JorgeSuarezPorras/ConvertidorElectronicoCC-CA/PCB_FINAL/PCB_FINAL.png

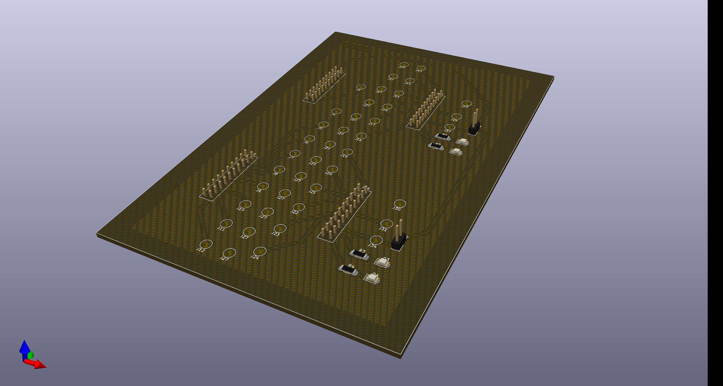
PCB_FINAL/PCB_FINAL.png
