JorgeSuarezPorras/ConvertidorElectronicoCC-CA/PCB_FINAL/PCB_BACK.pdf

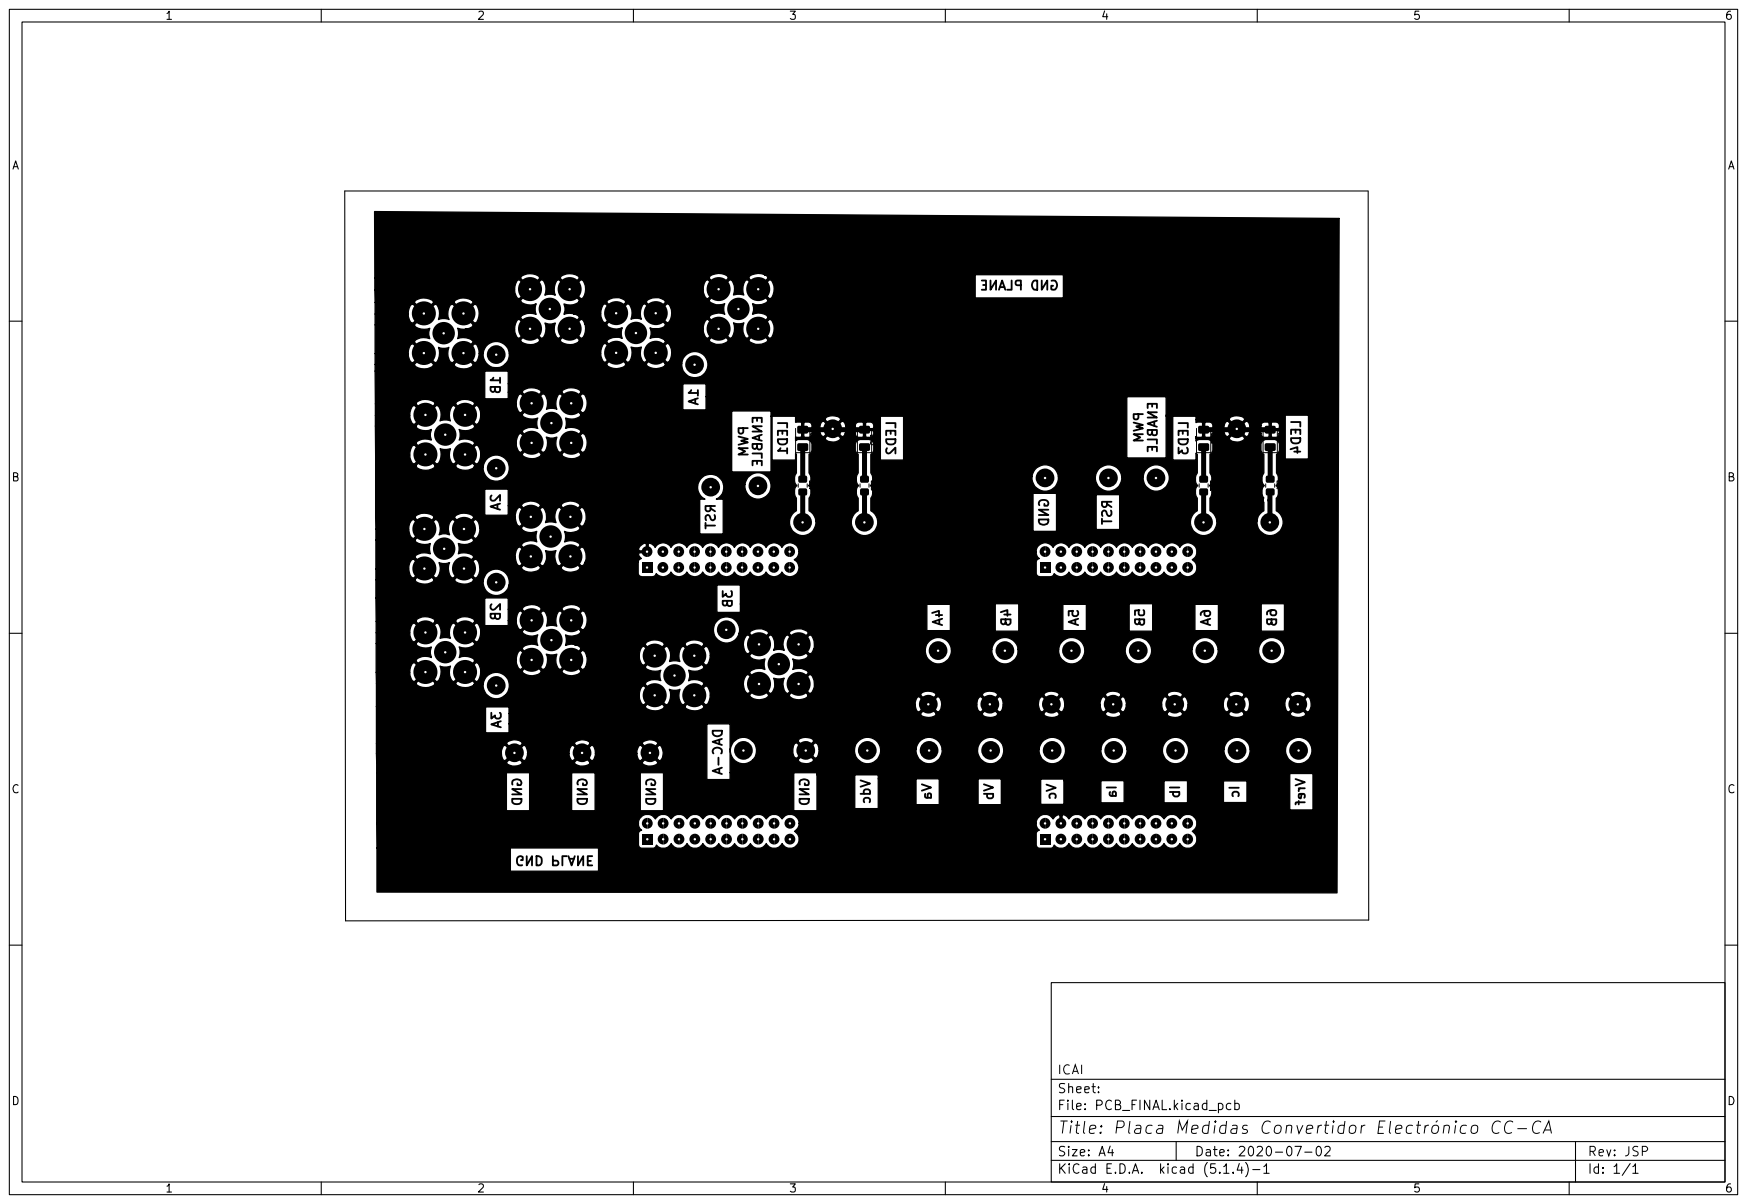
[picture p210: page 1]
