JorgeSuarezPorras/ConvertidorElectronicoCC-CA/PCB_FINAL/PCB_FRONT.pdf

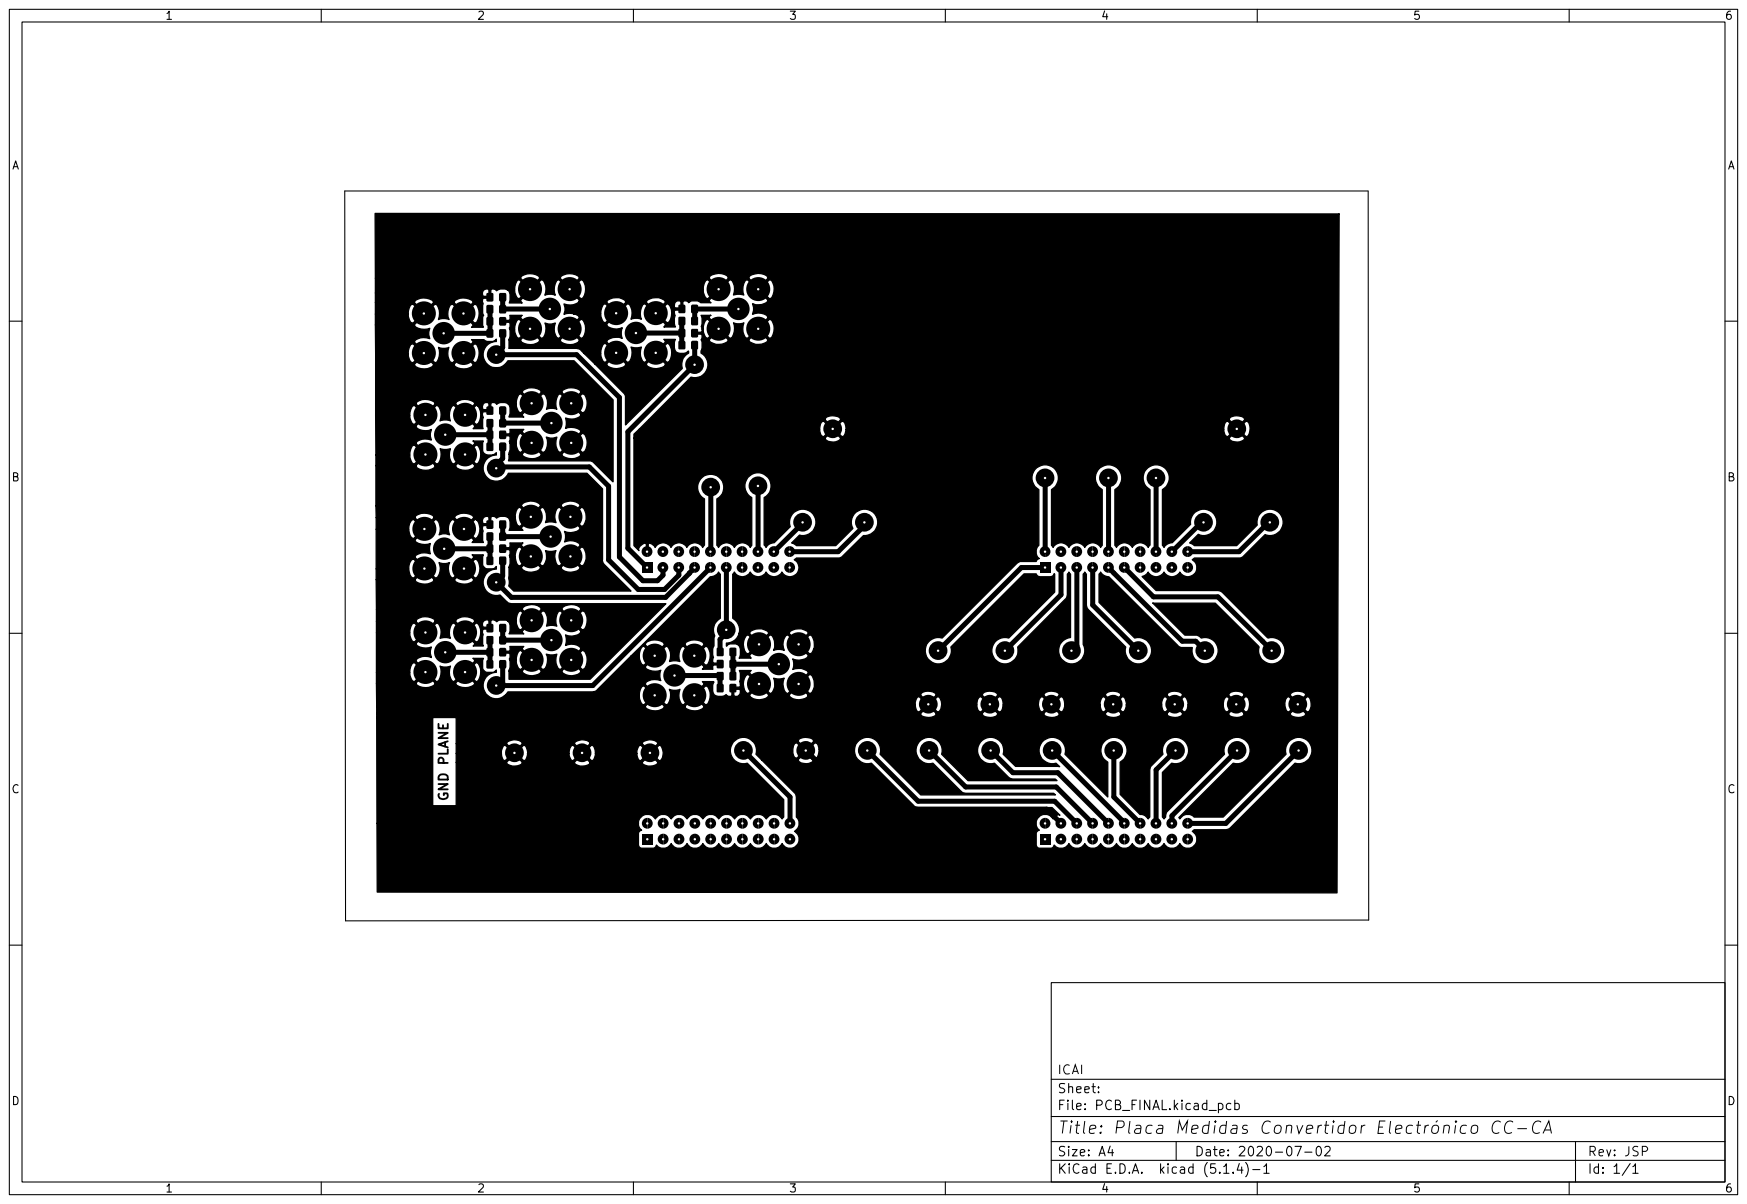
[picture p211: page 1]
