JorgeSuarezPorras/ConvertidorElectronicoCC-CA/PCB_FINAL/PCB_FINAL.kicad_pcb

## KiCad design PCB_FINAL/PCB_FINAL.kicad_pcb (2020-07-17)

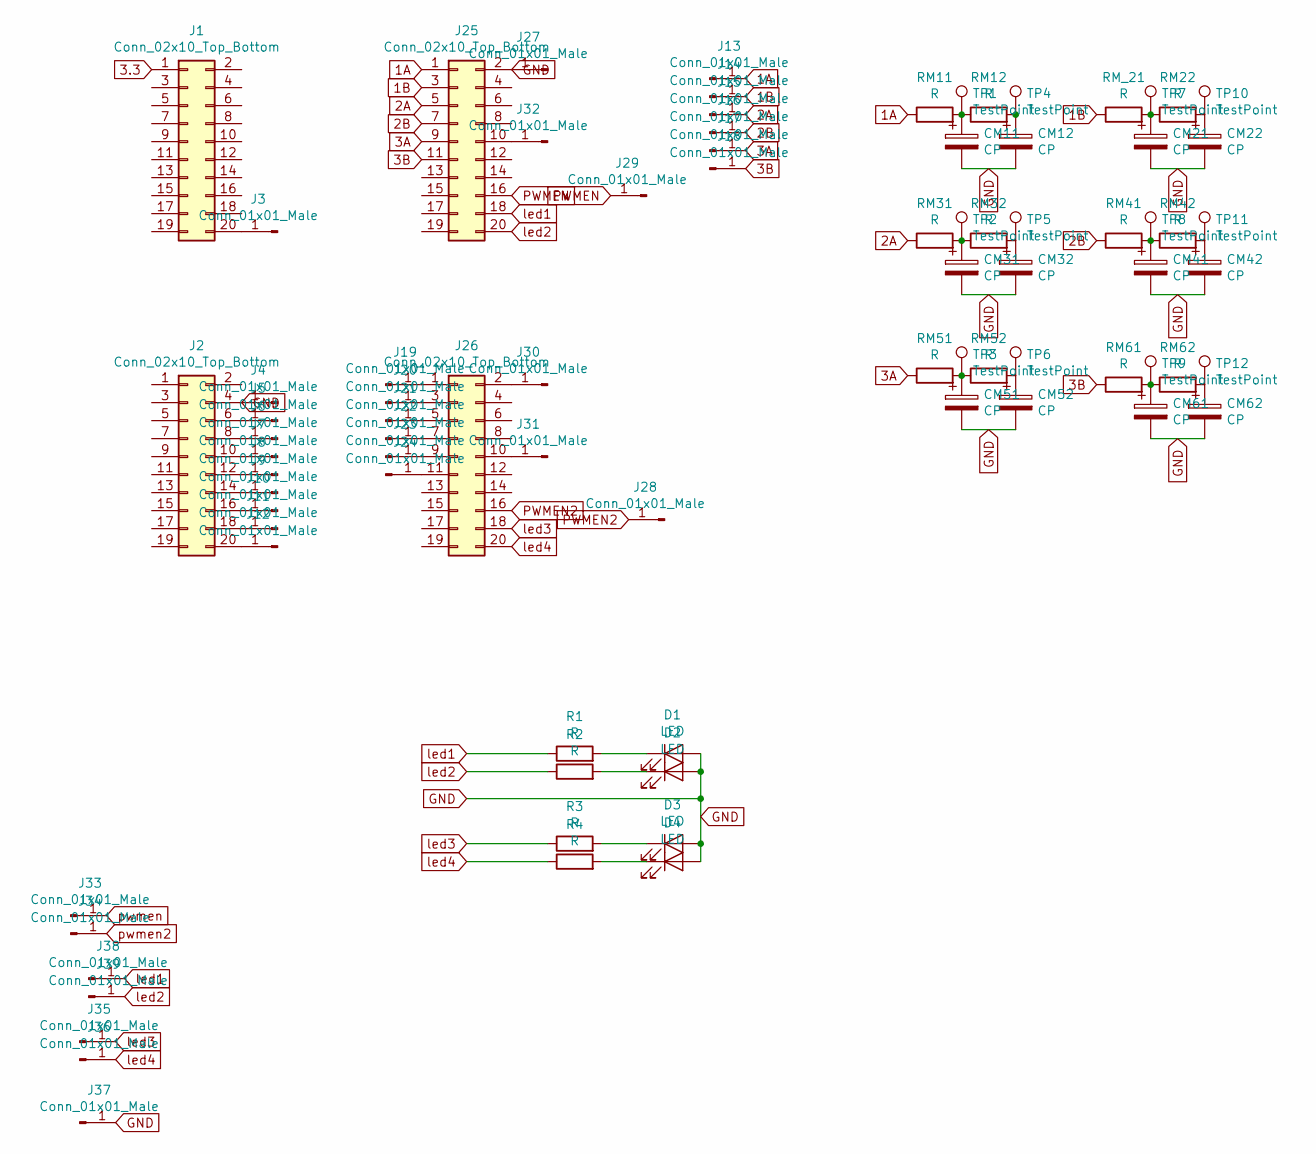
[picture p212: schematic PCB_FINAL.sch]

Parts:
CM11, CM12, CM21, CM22, CM31, CM32, CM41, CM42, CM51, CM52, CM61, CM62: CP; C_0805_2012Metric_Pad1.15x1.40mm_HandSolder
D1, D2, D3, D4: LED; LED_1206_3216Metric
J1, J2, J25, J26: Conn_02x10_Top_Bottom; PinHeader_2x10_P2.54mm_Vertical
J3, J4, J5, J6, J7, J8, J9, J10, J11, J12, J13, J14, J15, J16, J17, J18, J19, J20, J21, J22, J23, J24, J27, J28, J29, J30, J31, J32, J33, J34, J35, J36, J37, J38, J39: Conn_01x01_Male; TestPoint_Loop_D2.54mm_Drill1.5mm_Beaded
R1, R2, R3, R4: R; R_0805_2012Metric_Pad1.15x1.40mm_HandSolder
RM11, RM12, RM22, RM31, RM32, RM41, RM42, RM51, RM52, RM61, RM62: R; R_0805_2012Metric_Pad1.15x1.40mm_HandSolder
RM_21: R; R_0805_2012Metric_Pad1.15x1.40mm_HandSolder
TP1, TP2, TP3, TP4, TP5, TP6, TP7, TP8, TP9, TP10, TP11, TP12: TestPoint; BNC_TEConnectivity_1478204_Vertical

Connections:
1A: J13.1, J25.1, RM11.1
1B: J14.1, J25.3, RM_21.1
2A: J15.1, J25.5, RM31.1
2B: J16.1, J25.7, RM41.1
3.3: J1.1
3A: J17.1, J25.9, RM51.1
3B: J18.1, J25.11, RM61.1
GND: CM11.2, CM12.2, CM21.2, CM22.2, CM31.2, CM32.2, CM41.2, CM42.2, CM51.2, CM52.2, CM61.2, CM62.2, D1.2 (A), D2.2 (A), D3.2 (A), D4.2 (A), J2.4, J4.1, J25.2, J27.1, J37.1, TP1.2, TP2.2, TP3.2, TP4.2, TP5.2, TP6.2, TP7.2, TP8.2, TP9.2, TP10.2, TP11.2, TP12.2; also elsewhere on the board
unnamed: CM11.1, RM11.2, RM12.1, TP1.1
unnamed: CM12.1, RM12.2, TP4.1
unnamed: CM21.1, RM22.1, RM_21.2, TP7.1
unnamed: CM22.1, RM22.2, TP10.1
unnamed: CM31.1, RM31.2, RM32.1, TP2.1
unnamed: CM32.1, RM32.2, TP5.1
unnamed: CM41.1, RM41.2, RM42.1, TP8.1
unnamed: CM42.1, RM42.2, TP11.1
unnamed: CM51.1, RM51.2, RM52.1, TP3.1
unnamed: CM52.1, RM52.2, TP6.1
unnamed: CM61.1, RM61.2, RM62.1, TP9.1
unnamed: CM62.1, RM62.2, TP12.1
unnamed: D1.1 (K), R1.2
unnamed: D2.1 (K), R2.2
unnamed: D3.1 (K), R3.2
unnamed: D4.1 (K), R4.2
unnamed: J1.20, J3.1
unnamed: J2.6, J5.1
unnamed: J2.8, J6.1
unnamed: J2.10, J7.1
unnamed: J2.12, J8.1
unnamed: J2.14, J9.1
unnamed: J2.16, J10.1
unnamed: J2.18, J11.1
unnamed: J2.20, J12.1
unnamed: J19.1, J26.1
unnamed: J20.1, J26.3
unnamed: J21.1, J26.5
unnamed: J22.1, J26.7
unnamed: J23.1, J26.9
unnamed: J24.1, J26.11
unnamed: J25.10, J32.1
unnamed: J26.2, J30.1
unnamed: J26.10, J31.1
PWMEN: J25.16, J29.1
PWMEN2: J26.16, J28.1
led1: J25.18, J38.1, R1.1
led2: J25.20, J39.1, R2.1
led3: J26.18, J35.1, R3.1
led4: J26.20, J36.1, R4.1

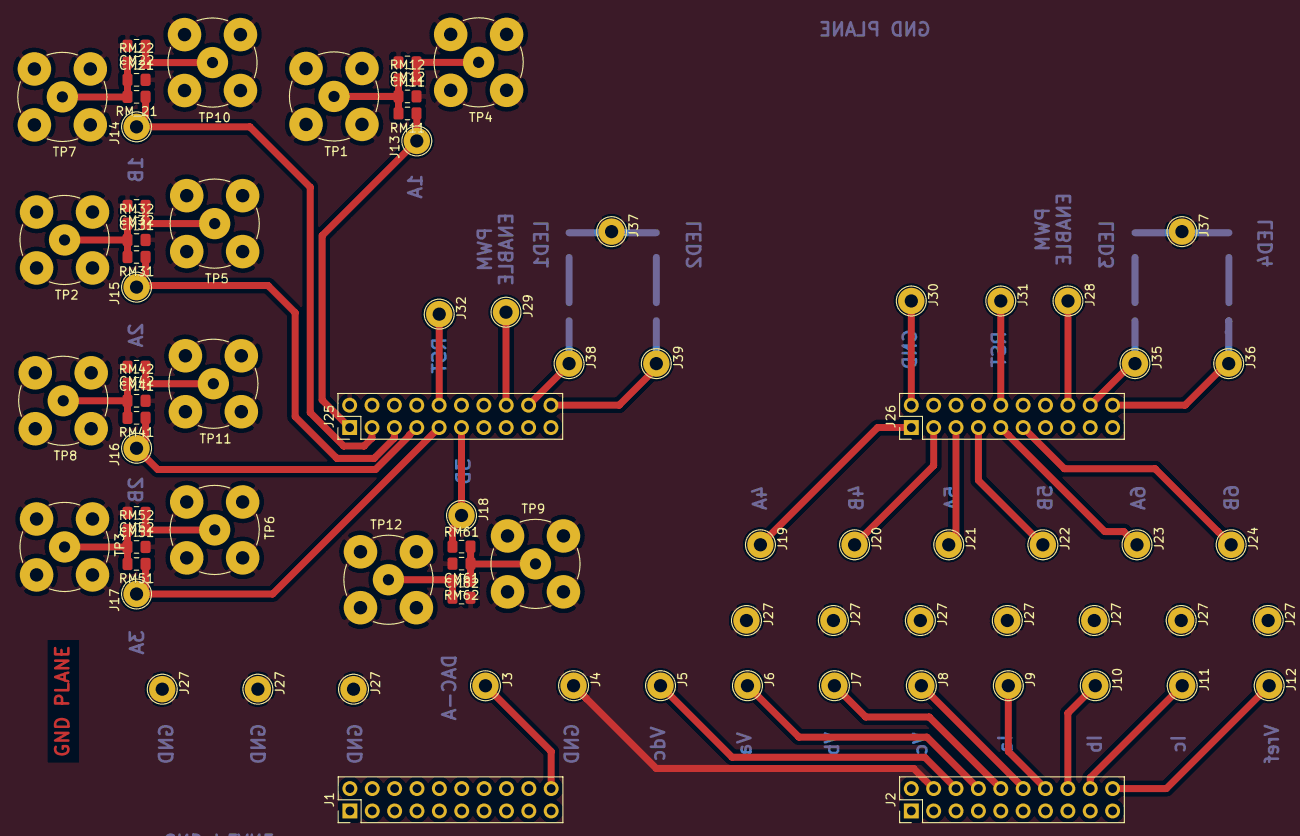
[picture p213: board PCB_FINAL.kicad_pcb from above]

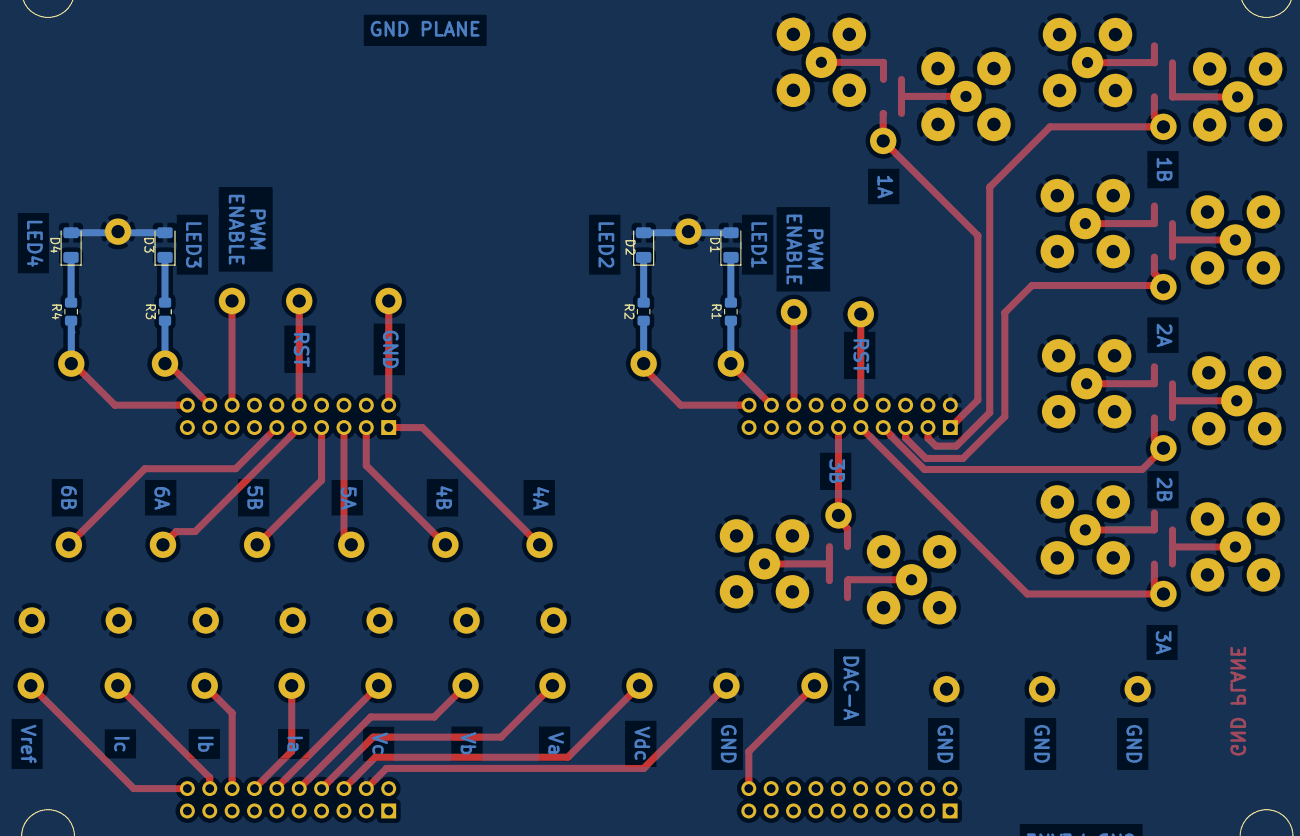
[picture p214: board PCB_FINAL.kicad_pcb from below]

Board: 2 copper layers, 91 parts (8 on the bottom side), 47 nets.

Other parts of the board:
J27#2, J27#3, J27#4, J27#5, J27#6, J27#7, J27#8, J27#9, J27#10, J37#2: Conn_01x01_Male; TestPoint_Loop_D2.54mm_Drill1.5mm_Beaded

Their connections:
GND: J27#2.1, J27#3.1, J27#4.1, J27#5.1, J27#6.1, J27#7.1, J27#8.1, J27#9.1, J27#10.1, J37#2.1; also elsewhere on the board
