JorgeSuarezPorras/ConvertidorElectronicoCC-CA/(commit log)

2020-02-06 Add files via upload
    Documento Trabajo fin de grado: Control de Corriente en un Convertidor CC- CA mediante Microcontrolador.
2020-06-11 Added and changed LED configurations
2020-06-26 Protocolo de Prácticas
2020-07-17 PCB Board for measurements
    Kicad board
    [PCB_FINAL.kicad_pcb, PCB_FINAL.sch]
2020-07-25 Added PCB design
2021-08-21 Protocolo de Prácticas
    Protocolo de prácticas para seguir en el laboratorio
